ShimmerNZ/EVE-2.0/convert/EveEye/lid-lower2.png

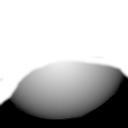
convert/EveEye/lid-lower2.png
