ShimmerNZ/EVE-2.0/convert/EveEye/lid-lower-symmetrical.png

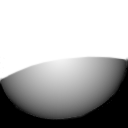
convert/EveEye/lid-lower-symmetrical.png
