ShimmerNZ/EVE-2.0/convert/EveEye/lid-upper2.png

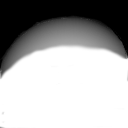
convert/EveEye/lid-upper2.png
