ShimmerNZ/EVE-2.0/convert/EveEye/sclera.png

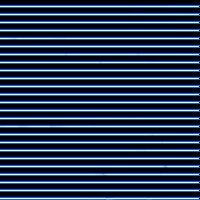
convert/EveEye/sclera.png
